MST-MRDT/Power-Patch-Panel/documentation/Dec11BoardreviewNotes.txt

change nmos from DSG to GSD
change pmos from DGS to GDS
