MST-MRDT/Power-Patch-Panel/documentation/PatchPanel.csv

Id | Designator | Package | Quantity | Designation | Item Name | Part Number | Vendor | Cost Per Item | Cost | URL
1 | REF**,REF**,REF**,REF** | 4_40_Hole | 4 | 4_40_Hole
2 | Conn2,Conn3,Conn4,Conn5,Conn6,Conn7,Conn8,Conn10,Conn11,Conn12,Conn13,Conn14,Conn15,Conn16,Conn1,Conn17 | Anderson_3_Vertical_Side_by_Side | 16 | AndersonPP | High Power 45 Amp Vertical Contact | 1335G1 | PowerWerx | $0.590 | $28.32 | https://powerwerx.com/anderson-1335g1-printed-circuit-board-vertical
3 | Q1,Q2,Q5,Q6,Q9,Q10,Q13,Q14,Q17,Q18,Q21,Q22,Q25,Q26,Q29,Q30 | TO-252-2 | 16 | Q_PMOS_GDS | BSS138 | 58K8769 | Newark | $0.302 | $4.83 | https://www.newark.com/on-semiconductor/bss138/n-channel-mosfet-50v-220ma-sot/dp/58K8769?mckv=sWT04h8On_dc|pcrid|220052116067|plid||kword|bss138|match|p|slid||product||pgrid|35708907088|ptaid|kwd-712589855|&s_kwcid=AL!8472!3!220052116067!p!!g!!bss138&CMP=KNC-GUSA-SKU-MDC
4 | Q3,Q4,Q7,Q8,Q11,Q12,Q15,Q16,Q19,Q20,Q23,Q24,Q27,Q28,Q31,Q32 | SOT-323_SC-70_Handsoldering | 16 | Q_NMOS_GSD | AOD4189 | 13762375 | Findchips | $0.132 | $2.10 | https://www.findchips.com/search/AOD4189?medium=tsa&sa360adenid=204272258574&gclsrc=aw.ds
5 | R1,R2,R3,R4,R5,R6,R7,R8,R9,R10,R11,R12,R13,R14,R15,R16,R17,R18,R19,R20,R21,R22,R23,R24,R27,R28,R29,R30,R31,R32,R33,R34 | R_0603_1608Metric_Pad1.05x0.95mm_HandSolder | 32 | 22k | CRGCQ0603F22K | 61AC6459 | Newark | $0.005 | $0.16 | https://www.newark.com/te-connectivity/crgcq0603f22k/res-22k-1-0603-thick-film/dp/61AC6459?st=RES,%2022K,%201%25,%200603
6 | Conn18,Conn9 | Anderson_2_Vertical_Sidy_by_Side | 2 | AndersonPP | High Power 45 Amp Vertical Contact | 1335G1 | PowerWerx | $0.590 | $2.36 | https://powerwerx.com/anderson-1335g1-printed-circuit-board-vertical
7 | Conn19 | PinHeader_2x05_P1.27mm_Vertical | 1 | 10PinHeader | CNC Tech 3220-10-0100-00 | 1175-1627-ND | Digikey | $0.58 | $0.58 | https://www.digikey.com/product-detail/en/cnc-tech/3220-10-0100-00/1175-1627-ND/3883661
8 | D3,D4,D5,D6,D7,D8,D9,D10 | LED_0603_1608Metric_Pad1.05x0.95mm_HandSolder | 8 | OrangeLED | SML-LX0603SOW-TR | 28M9279 | Newark | $0.117 | $0.94 | https://www.newark.com/lumex/sml-lx0603sow-tr/led-orange-0-8mm-x-1mm-60mcd-610nm/dp/28M9279
9 | R35,R36,R37,R38,R39,R40,R41,R42 | R_0603_1608Metric_Pad1.05x0.95mm_HandSolder | 8 | 300
