MST-MRDT/Power-Patch-Panel/PatchPanel_Hardware/PatchPanel.kicad_pcb

## KiCad design PatchPanel_Hardware/PatchPanel.kicad_pcb (2020-09-11)

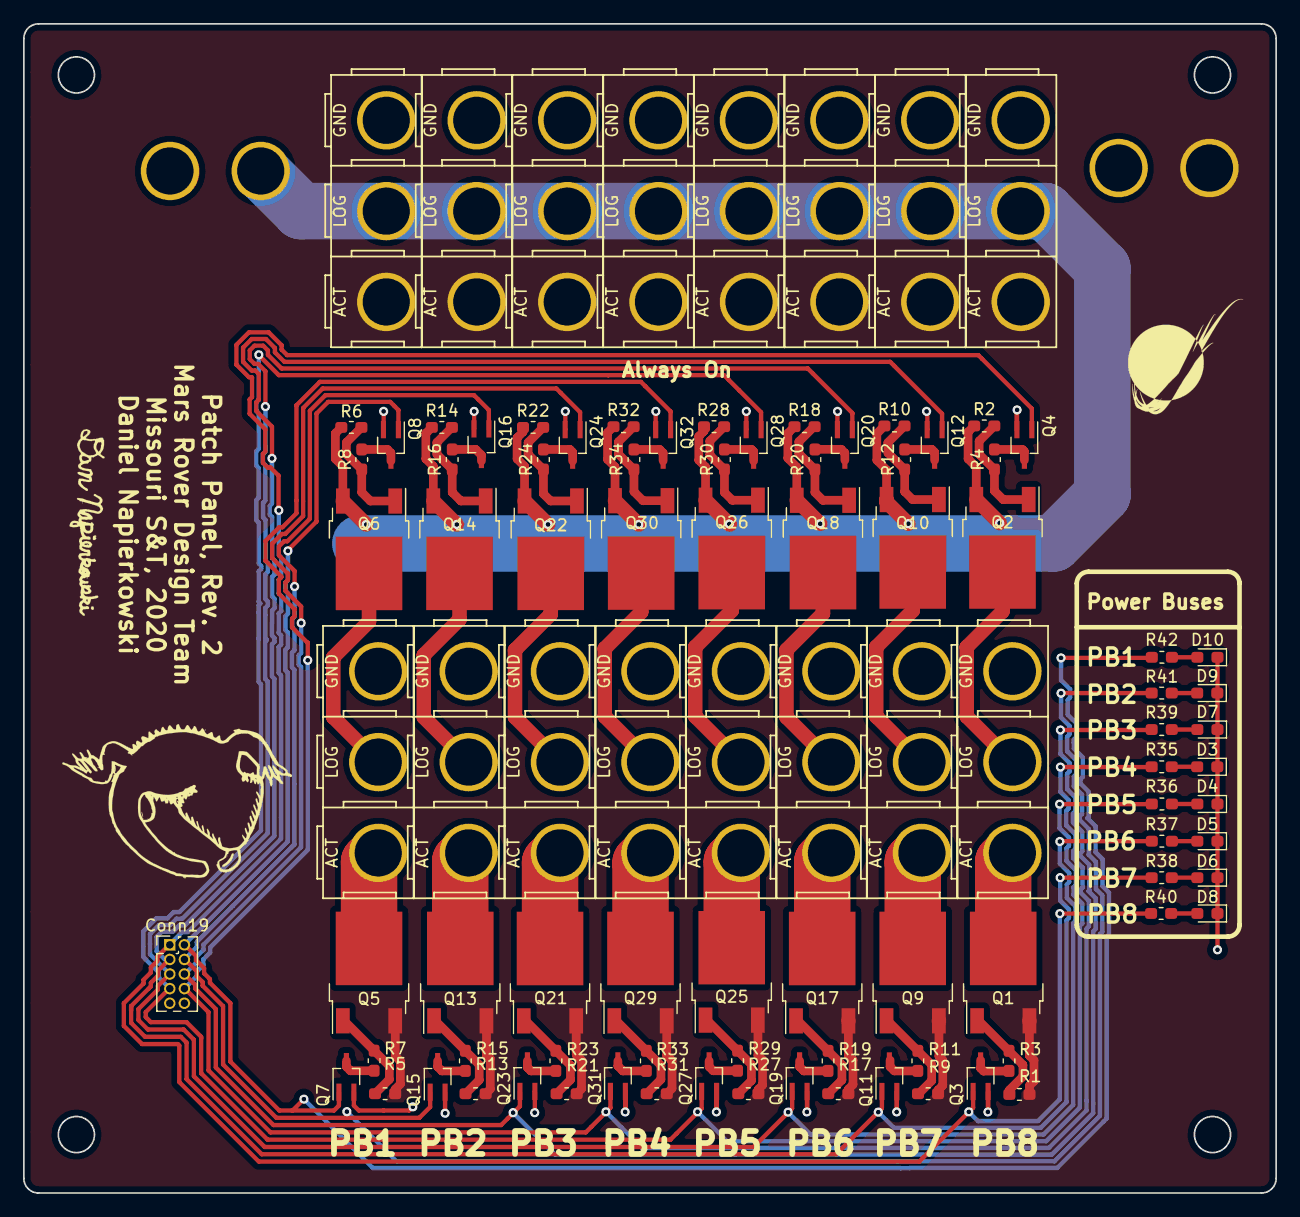
[picture p1: board PatchPanel.kicad_pcb from above]

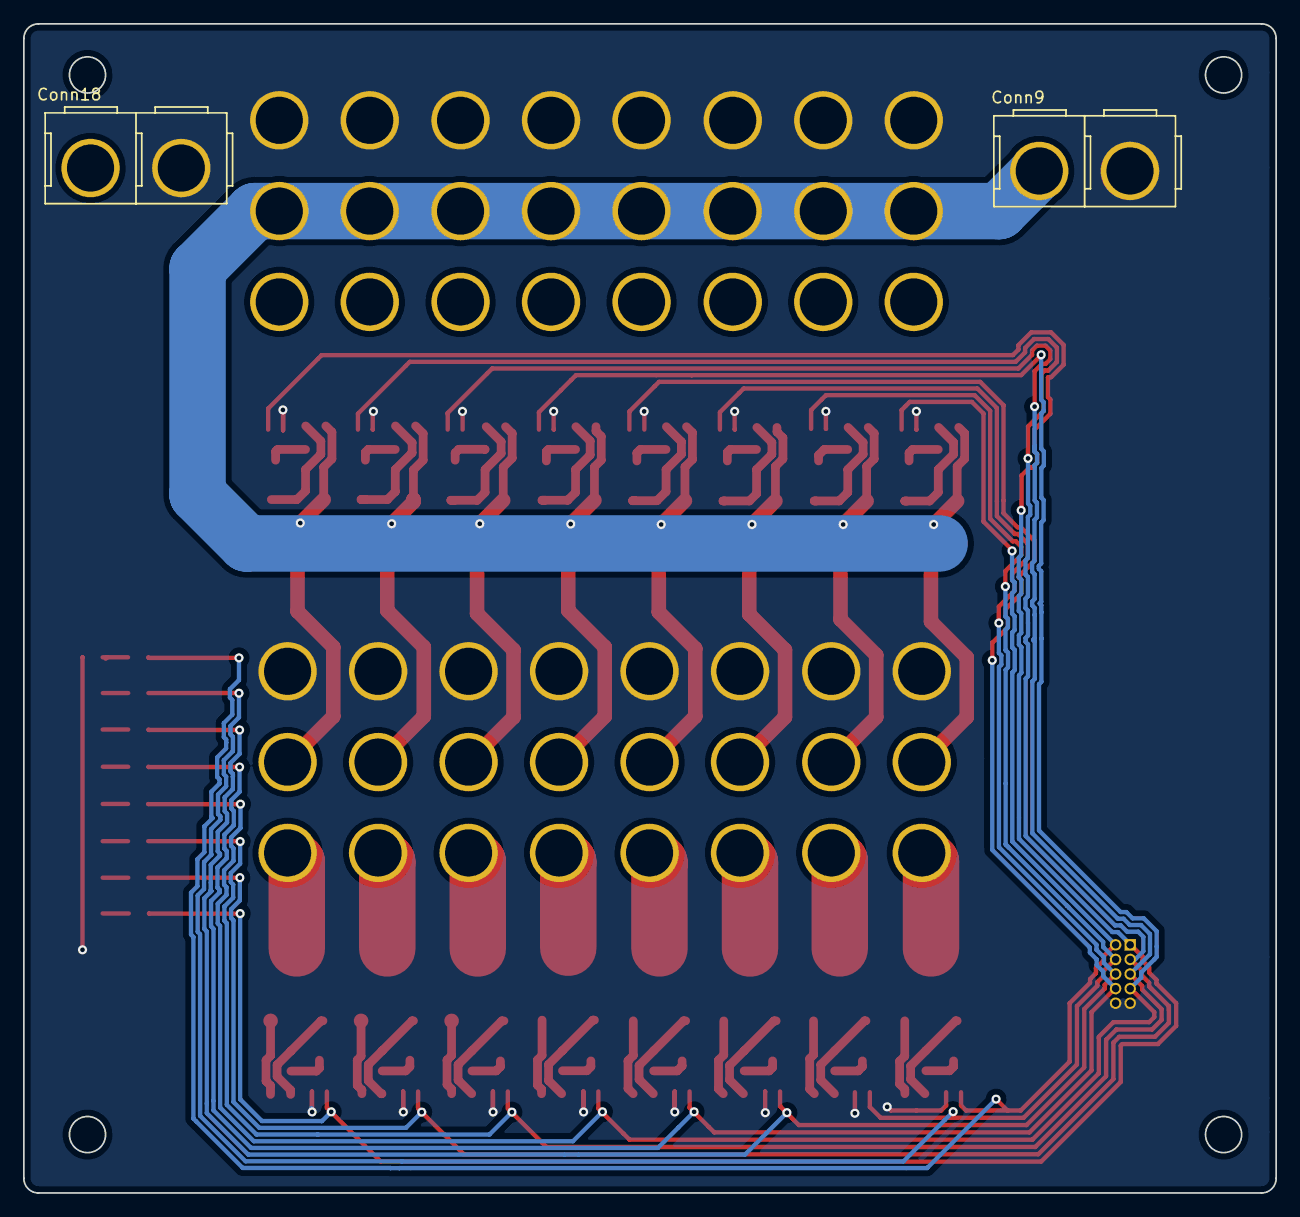
[picture p2: board PatchPanel.kicad_pcb from below]

Board: 2 copper layers, 109.0 x 101.7 mm, 99 parts (2 on the bottom side), 67 nets.

Parts:
Conn1, Conn2, Conn3, Conn4, Conn5, Conn6, Conn7, Conn8, Conn10, Conn11, Conn12, Conn13, Conn14, Conn15, Conn16, Conn17: AndersonPP; Anderson_3_Vertical_Side_by_Side
Conn9, Conn18: AndersonPP; Anderson_2_Vertical_Sidy_by_Side
Conn19: Molex_SL_10; PinHeader_2x05_P1.27mm_Vertical
D3, D4, D5, D6, D7, D8, D9, D10: OrangeLED; LED_0603_1608Metric_Pad1.05x0.95mm_HandSolder
Q1, Q2, Q5, Q6, Q9, Q10, Q13, Q14, Q17, Q18, Q21, Q22, Q25, Q26, Q29, Q30: Q_PMOS_GDS; TO-252-2
Q3, Q4, Q7, Q8, Q11, Q12, Q15, Q16, Q19, Q20, Q23, Q24, Q27, Q28, Q31, Q32: Q_NMOS_GSD; SOT-323_SC-70_Handsoldering
R1, R2, R3, R4, R5, R6, R7, R8, R9, R10, R11, R12, R13, R14, R15, R16, R17, R18, R19, R20, R21, R22, R23, R24, R27, R28, R29, R30, R31, R32, R33, R34: 22k; R_0603_1608Metric_Pad1.05x0.95mm_HandSolder
R35, R36, R37, R38, R39, R40, R41, R42: 300; R_0603_1608Metric_Pad1.05x0.95mm_HandSolder

Connections:
/Vact: Conn10.3, Conn11.3, Conn12.3, Conn13.3, Conn14.3, Conn15.3, Conn16.3, Conn17.3, Conn18.2, Q1.3, Q5.3, Q9.3, Q13.3, Q17.3, Q21.3, Q25.3, Q29.3, R1.2, R5.2, R9.2, R13.2, R17.2, R21.2, R27.2, R31.2
/Vlog: Conn9.2, Conn10.2, Conn11.2, Conn12.2, Conn13.2, Conn14.2, Conn15.2, Conn16.2, Conn17.2, Q2.3, Q6.3, Q10.3, Q14.3, Q18.3, Q22.3, Q26.3, Q30.3, R2.2, R6.2, R10.2, R14.2, R18.2, R22.2, R28.2, R32.2
GND: Conn1.1, Conn2.1, Conn3.1, Conn4.1, Conn5.1, Conn6.1, Conn7.1, Conn8.1, Conn9.1, Conn10.1, Conn11.1, Conn12.1, Conn13.1, Conn14.1, Conn15.1, Conn16.1, Conn17.1, Conn18.1, Conn19.9, Conn19.10, D3.1, D4.1, D5.1, D6.1, D7.1, D8.1, D9.1, D10.1, Q3.2, Q4.2, Q7.2, Q8.2, Q11.2, Q12.2, Q15.2, Q16.2, Q19.2, Q20.2, Q23.2, Q24.2, Q27.2, Q28.2, Q31.2, Q32.2
unnamed: Conn1.2, Q2.2
unnamed: Conn1.3, Q1.2
unnamed: Conn2.2, Q6.2
unnamed: Conn2.3, Q5.2
unnamed: Conn3.2, Q10.2
unnamed: Conn3.3, Q9.2
unnamed: Conn4.2, Q14.2
unnamed: Conn4.3, Q13.2
unnamed: Conn5.2, Q18.2
unnamed: Conn5.3, Q17.2
unnamed: Conn6.2, Q22.2
unnamed: Conn6.3, Q21.2
unnamed: Conn7.2, Q26.2
unnamed: Conn7.3, Q25.2
unnamed: Conn8.2, Q30.2
unnamed: Conn8.3, Q29.2
unnamed: D3.2, R35.2
unnamed: D4.2, R36.2
unnamed: D5.2, R37.2
unnamed: D6.2, R38.2
unnamed: D7.2, R39.2
unnamed: D8.2, R40.2
unnamed: D9.2, R41.2
unnamed: D10.2, R42.2
unnamed: Q1.1, R1.1, R3.2
unnamed: Q2.1, R2.1, R4.2
unnamed: Q3.3, R3.1
unnamed: Q4.3, R4.1
unnamed: Q5.1, R5.1, R7.2
unnamed: Q6.1, R6.1, R8.2
unnamed: Q7.3, R7.1
unnamed: Q8.3, R8.1
unnamed: Q9.1, R9.1, R11.2
unnamed: Q10.1, R10.1, R12.2
unnamed: Q11.3, R11.1
unnamed: Q12.3, R12.1
unnamed: Q13.1, R13.1, R15.2
unnamed: Q14.1, R14.1, R16.2
unnamed: Q15.3, R15.1
unnamed: Q16.3, R16.1
unnamed: Q17.1, R17.1, R19.2
unnamed: Q18.1, R18.1, R20.2
unnamed: Q19.3, R19.1
unnamed: Q20.3, R20.1
unnamed: Q21.1, R21.1, R23.2
unnamed: Q22.1, R22.1, R24.2
unnamed: Q23.3, R23.1
unnamed: Q24.3, R24.1
unnamed: Q25.1, R27.1, R29.2
unnamed: Q26.1, R28.1, R30.2
unnamed: Q27.3, R29.1
unnamed: Q28.3, R30.1
unnamed: Q29.1, R31.1, R33.2
unnamed: Q30.1, R32.1, R34.2
unnamed: Q31.3, R33.1
unnamed: Q32.3, R34.1
PB1: Conn19.2, Q7.1, Q8.1, R42.1
PB2: Conn19.4, Q15.1, Q16.1, R41.1
PB3: Conn19.6, Q23.1, Q24.1, R39.1
PB4: Conn19.8, Q31.1, Q32.1, R35.1
PB5: Conn19.7, Q27.1, Q28.1, R36.1
PB6: Conn19.5, Q19.1, Q20.1, R37.1
PB7: Conn19.3, Q11.1, Q12.1, R38.1
PB8: Conn19.1, Q3.1, Q4.1, R40.1
