MST-MRDT/Power-Patch-Panel/(commit log)

2015-11-01 Create patch panel V1
    [Patch_Panel.brd, Patch_Panel.sch]
2015-11-01 Added BOM
    [Patch_Panel_BOM.xlsx]
2015-12-02 Removed 2-pin Connectors and RJ45 Pass-Through
    [Patch_Panel.brd, Patch_Panel.sch]
2016-01-13 added moco power patch-thru, rearr 3-pin, gen dx
    [Patch_Panel.brd, Patch_Panel.dxf, Patch_Panel.sch]
2016-01-13 Revert "added moco power patch-thru, rearr 3-pin, gen dx"
    This reverts commit e393c53abb352ea2a1f007c95e73af8e49a976a5.
    [Patch_Panel.brd, Patch_Panel.dxf, Patch_Panel.sch]
2016-01-13 un-deleted brd file and re-added dxf
    [Patch_Panel.brd, Patch_Panel.dxf]
2016-01-13 imported new mlx connectors
    [Patch_Panel.brd, Patch_Panel.sch]
2016-01-15 totally re-made patch panel, gen dxf
    [Patch_Panel.dxf]
2016-01-15 added missing route
    [Patch_Panel.brd]
2016-01-16 Added ethernet hole
    [Patch_Panel.brd]
2016-01-19 added cutout, rerouted w/ vert app connectors for power in
    [Patch_Panel.brd, Patch_Panel.sch]
2016-01-19 added rj45 standoff - needs placed
    [Patch_Panel.brd, Patch_Panel.sch]
2016-01-21 github sucks. i changed some stuff
    [Patch_Panel.brd, Patch_Panel.sch]
2016-01-22 FINAL PATCH PANEL REV 1
    [Patch_Panel.GBL, Patch_Panel.GBS, Patch_Panel.GTL, Patch_Panel.GTO, Patch_Panel.GTS]
2016-11-06 2017 Patch Panel
    This patch panel for 2017 has 4 connections for the Logic bus, 6
    connections for the Logic & Actuation bus, 4 connections for the
    Actuation bus, and 2 connections for an extra bus.
    [Patch-Panel.brd, Patch-Panel.sch, Patch_Panel.brd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]
2016-11-08 Last edits before fabrication
    tidied a couple traces and labels, and added a martian.
    [Patch-Panel.brd, Patch-Panel.sch]
2017-11-08 2018 Patch Panel Rev1
    The 12V buses are being passed to patch panel. In order from bottom of power board to top, Actuation 15A, Logic 5A, Communication 5A. There is no extra bus this year. Add one more Logic/Act connection
    [Patch-Panel.brd, Patch-Panel.sch]
2017-11-09 Font changed to vector
    [Patch-Panel.brd]
2018-03-15 Patch Panel Rev 2
    Eliminates all exclusive logic buses and added seven more actuation/logic combo buses. Added one more comm bus
    [Patch-Panel.brd]
2018-03-25 Rev.3 to Change Mounting Hole Locations
    Mounting holes on Rev.2 are incorrect because power board's size changed slightly and we only realized the holes didnt match up after we ordered Rev.2
    [Patch-Panel.brd]
2018-03-26 Adjusted bottom anderson positions
    [Patch-Panel.brd]
2018-03-26 Added gitignore and fixed silkscreen
    [Patch-Panel.brd]
2018-12-07 Created project and completed schematic
    [Patch-Panel.brd, PatchPanel_Hardware.kicad_pcb, PatchPanel_Hardware.sch]
2018-12-13 Symbols named and packages assigned
    [PatchPanel_Hardware.kicad_pcb, PatchPanel_Hardware.sch]
2018-12-13 Outline and Hole Placement Complete
    [PatchPanel_Hardware.kicad_pcb]
2018-12-13 Placed Double Andersons
    [PatchPanel_Hardware.kicad_pcb]
2018-12-14 Placed Connectors & Routed Traces
    [PatchPanel_Hardware.kicad_pcb, PatchPanel_Hardware.sch]
2018-12-14 Added Silkscreen
    [PatchPanel_Hardware.kicad_pcb]
2018-12-14 Created BOM
    [PatchPanel_Hardware_BOM.csv]
2018-12-31 Created Gerbs
    [PatchPanel_Hardware-B.Cu.gbr, PatchPanel_Hardware-B.Mask.gbr, PatchPanel_Hardware-B.Paste.gbr, PatchPanel_Hardware-B.SilkS.gbr, PatchPanel_Hardware-Edge.Cuts.gbr, PatchPanel_Hardware-F.Cu.gbr, PatchPanel_Hardware-F.Mask.gbr, PatchPanel_Hardware-F.Paste.gbr]
2019-01-17 update rev 2 library
    [PatchPanel_Hardware.kicad_pcb, PatchPanel_Hardware.sch, PatchPanel_Hardware.step]
2019-10-10 finished PCBdesign
    [PatchPanel.kicad_pcb, PatchPanel_Hardware_BOM.csv]
2019-10-10 ready for PDR
    [PatchPanel.sch]
2019-10-31 ready for board review
    [PatchPanel.kicad_pcb, PatchPanel.sch]
2019-11-18 add input label
    [PatchPanel.kicad_pcb]
2019-11-21 final change
    [PatchPanel.kicad_pcb, PatchPanel.sch]
2019-11-21 before review
    [PatchPanel.kicad_pcb, PatchPanel.sch]
2019-11-26 fixed board review issue
    [PatchPanel.kicad_pcb, PatchPanel.sch]
2019-12-11 change molex
    [PatchPanel.kicad_pcb, PatchPanel.sch]
2019-12-11 add LED to anderson
    [PatchPanel.kicad_pcb, PatchPanel.sch]
2019-12-11 add gerbs
    [PatchPanel-B.Cu.gbr, PatchPanel-B.Mask.gbr, PatchPanel-B.Paste.gbr, PatchPanel-B.SilkS.gbr, PatchPanel-Edge.Cuts.gbr, PatchPanel-F.Cu.gbr, PatchPanel-F.Mask.gbr, PatchPanel-F.Paste.gbr]
2019-12-15 fix bom file
    [PatchPanel.csv]
2020-03-06 Redid entire schematic to be more organized and compact
    [PatchPanel.kicad_pcb]
2020-03-06 added some silks, generated Gerbs
    [PatchPanel-B.Cu.gbr, PatchPanel-B.Mask.gbr, PatchPanel-B.SilkS.gbr, PatchPanel-B_Cu.gbr, PatchPanel-B_Mask.gbr, PatchPanel-B_Paste.gbr, PatchPanel-B_SilkS.gbr, PatchPanel-Edge.Cuts.gbr]
